anonymouschichvy/FishTrack-Buoy/open_echo/development/TUSS4470_PCB_ECHO/assembly.FCStd

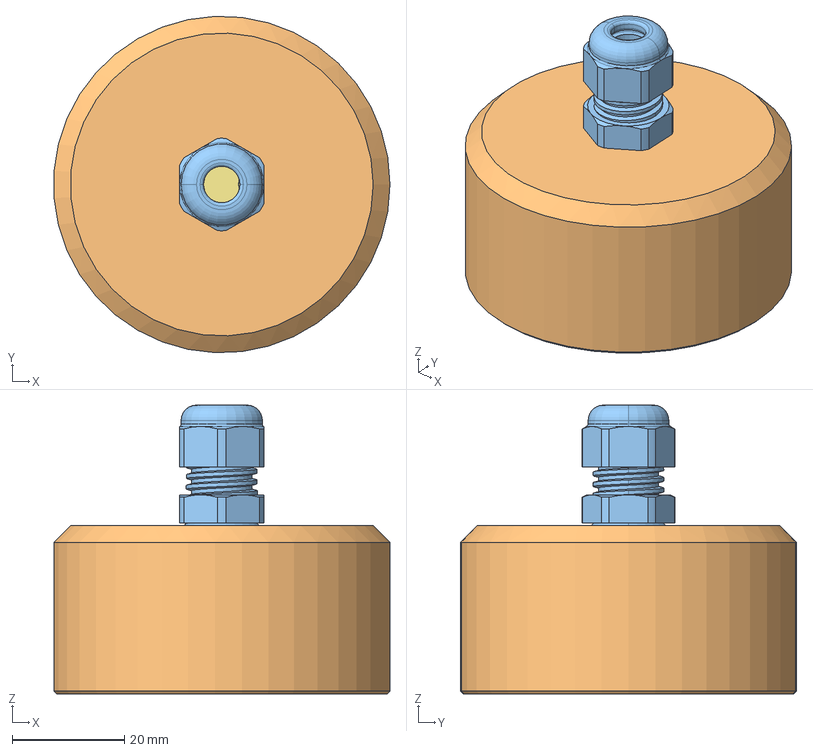
[picture p7: CAD file, 2026-06-20, last stored version]
open_echo/development/TUSS4470_PCB_ECHO/assembly.FCStd
59.9 x 60.0 x 51.5 mm
C_1206_3216Metric
R_1206_3216Metric
C_0402_1005Metric
R_0603_1608Metric
LED_0805_2012Metric
R_0603_1608Metric002
R_0402_1005Metric
C_0402_1005Metric002
QFN-20-1EP_4x4mm_Pitch0.5mm
D_SMA
R_0603_1608Metric004
C_0603_1608Metric
R_0603_1608Metric006
C_0402_1005Metric004
C_1206_3216Metric002
LED_0805_2012Metric002
LED_0805_2012Metric004
LQFP_48_7x7mm_P05mm
C_0603_1608Metric002
C_0603_1608Metric004
C_0402_1005Metric006
C_1206_3216Metric004
R_0603_1608Metric008
LED_0805_2012Metric006
C_1206_3216Metric006
C_0603_1608Metric006
SOT_223
R_1206_3216Metric002
LED_0805_2012Metric008
Crystal_SMD_5032-2Pin_5.0x3.2mm
C_0402_1005Metric008
C_0402_1005Metric010
C_0603_1608Metric008
R_0603_1608Metric010
R_0603_1608Metric012
R_0603_1608Metric014
C_1206_3216Metric008
C_0603_1608Metric010
QFN-28-1EP_5x5mm_Pitch0.5mm
_autosave-TUSS4470_shield_PCB
69915K47_Plastic Submersible Cord Grip
