anonymouschichvy/FishTrack-Buoy/open_echo/development/TUSS4470_PCB_ECHO/TUSS4470_shield/components/TUSS4470TRTJR.step

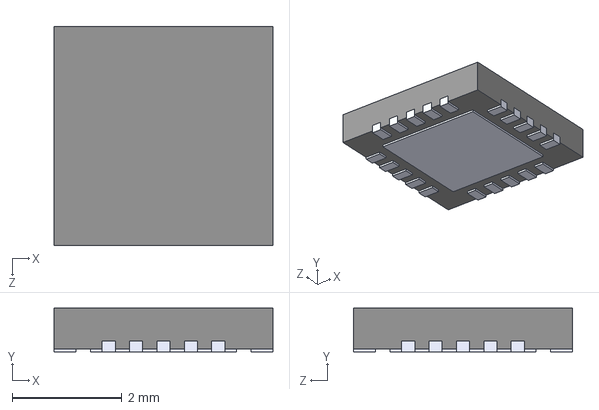
[picture p8: CAD file, 2026-06-20, last stored version]
open_echo/development/TUSS4470_PCB_ECHO/TUSS4470_shield/components/TUSS4470TRTJR.step
4.00 x 0.8 x 4.00 mm
