anonymouschichvy/FishTrack-Buoy/open_echo/TUSS4470_shield_002/TUSS4470_shield_hardware/TUSS4470_shield/TUSS4470_shield.step

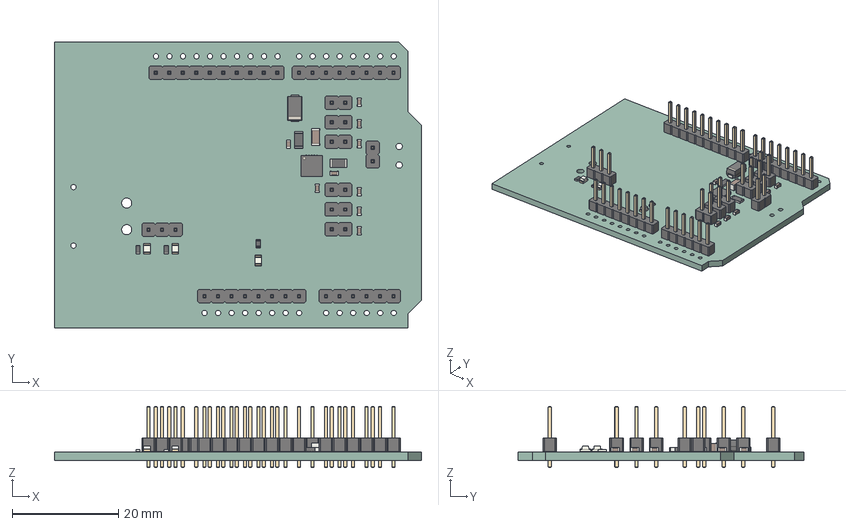
[picture p9: CAD file, 2026-06-20, last stored version]
open_echo/TUSS4470_shield_002/TUSS4470_shield_hardware/TUSS4470_shield/TUSS4470_shield.step
69.0 x 53.8 x 11.5 mm
R_1206_3216Metric x 2
LED_0805_2012Metric x 3
QFN-20-1EP_4x4mm_Pitch0.5mm
D_SMA
C_0603_1608Metric x 9
PinHeader_1x02_P254mm_Vertical x 7
PinHeader_1x06_P254mm_Vertical
R_0603_1608Metric x 3
C_1206_3216Metric
PinHeader_1x08_P254mm_Vertical x 2
PinHeader_1x10_P254mm_Vertical
PinHeader_1x03_P254mm_Vertical
TUSS4470_shield_PCB
