anonymouschichvy/FishTrack-Buoy/open_echo/development/TUSS4470_PCB_ECHO/TUSS4470_shield/components/piezo_3d.step

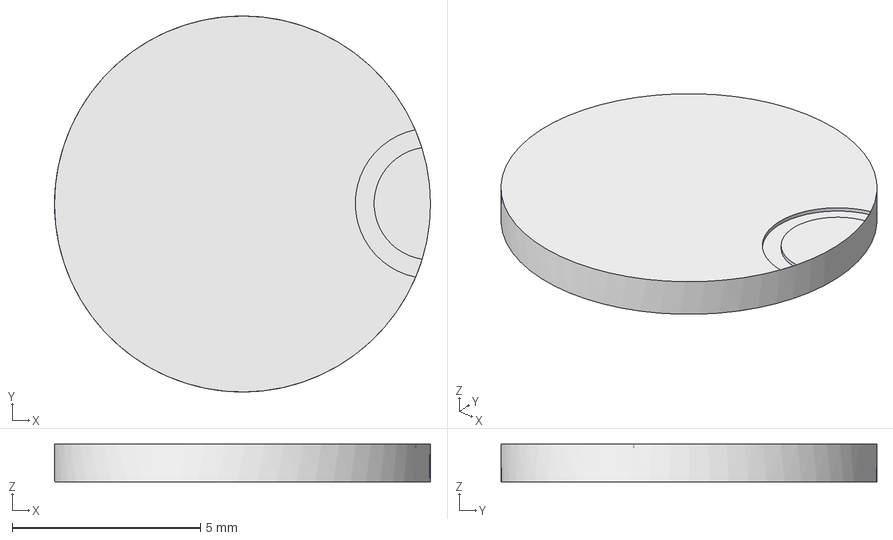
[picture p10: CAD file, 2026-06-20, last stored version]
open_echo/development/TUSS4470_PCB_ECHO/TUSS4470_shield/components/piezo_3d.step
10.00 x 10.00 x 1.00 mm
