anonymouschichvy/FishTrack-Buoy/open_echo/development/phased_array_001_pico/phased.kicad_pcb

## KiCad design open_echo/development/phased_array_001_pico/phased.kicad_pcb (2026-06-20, last stored version)

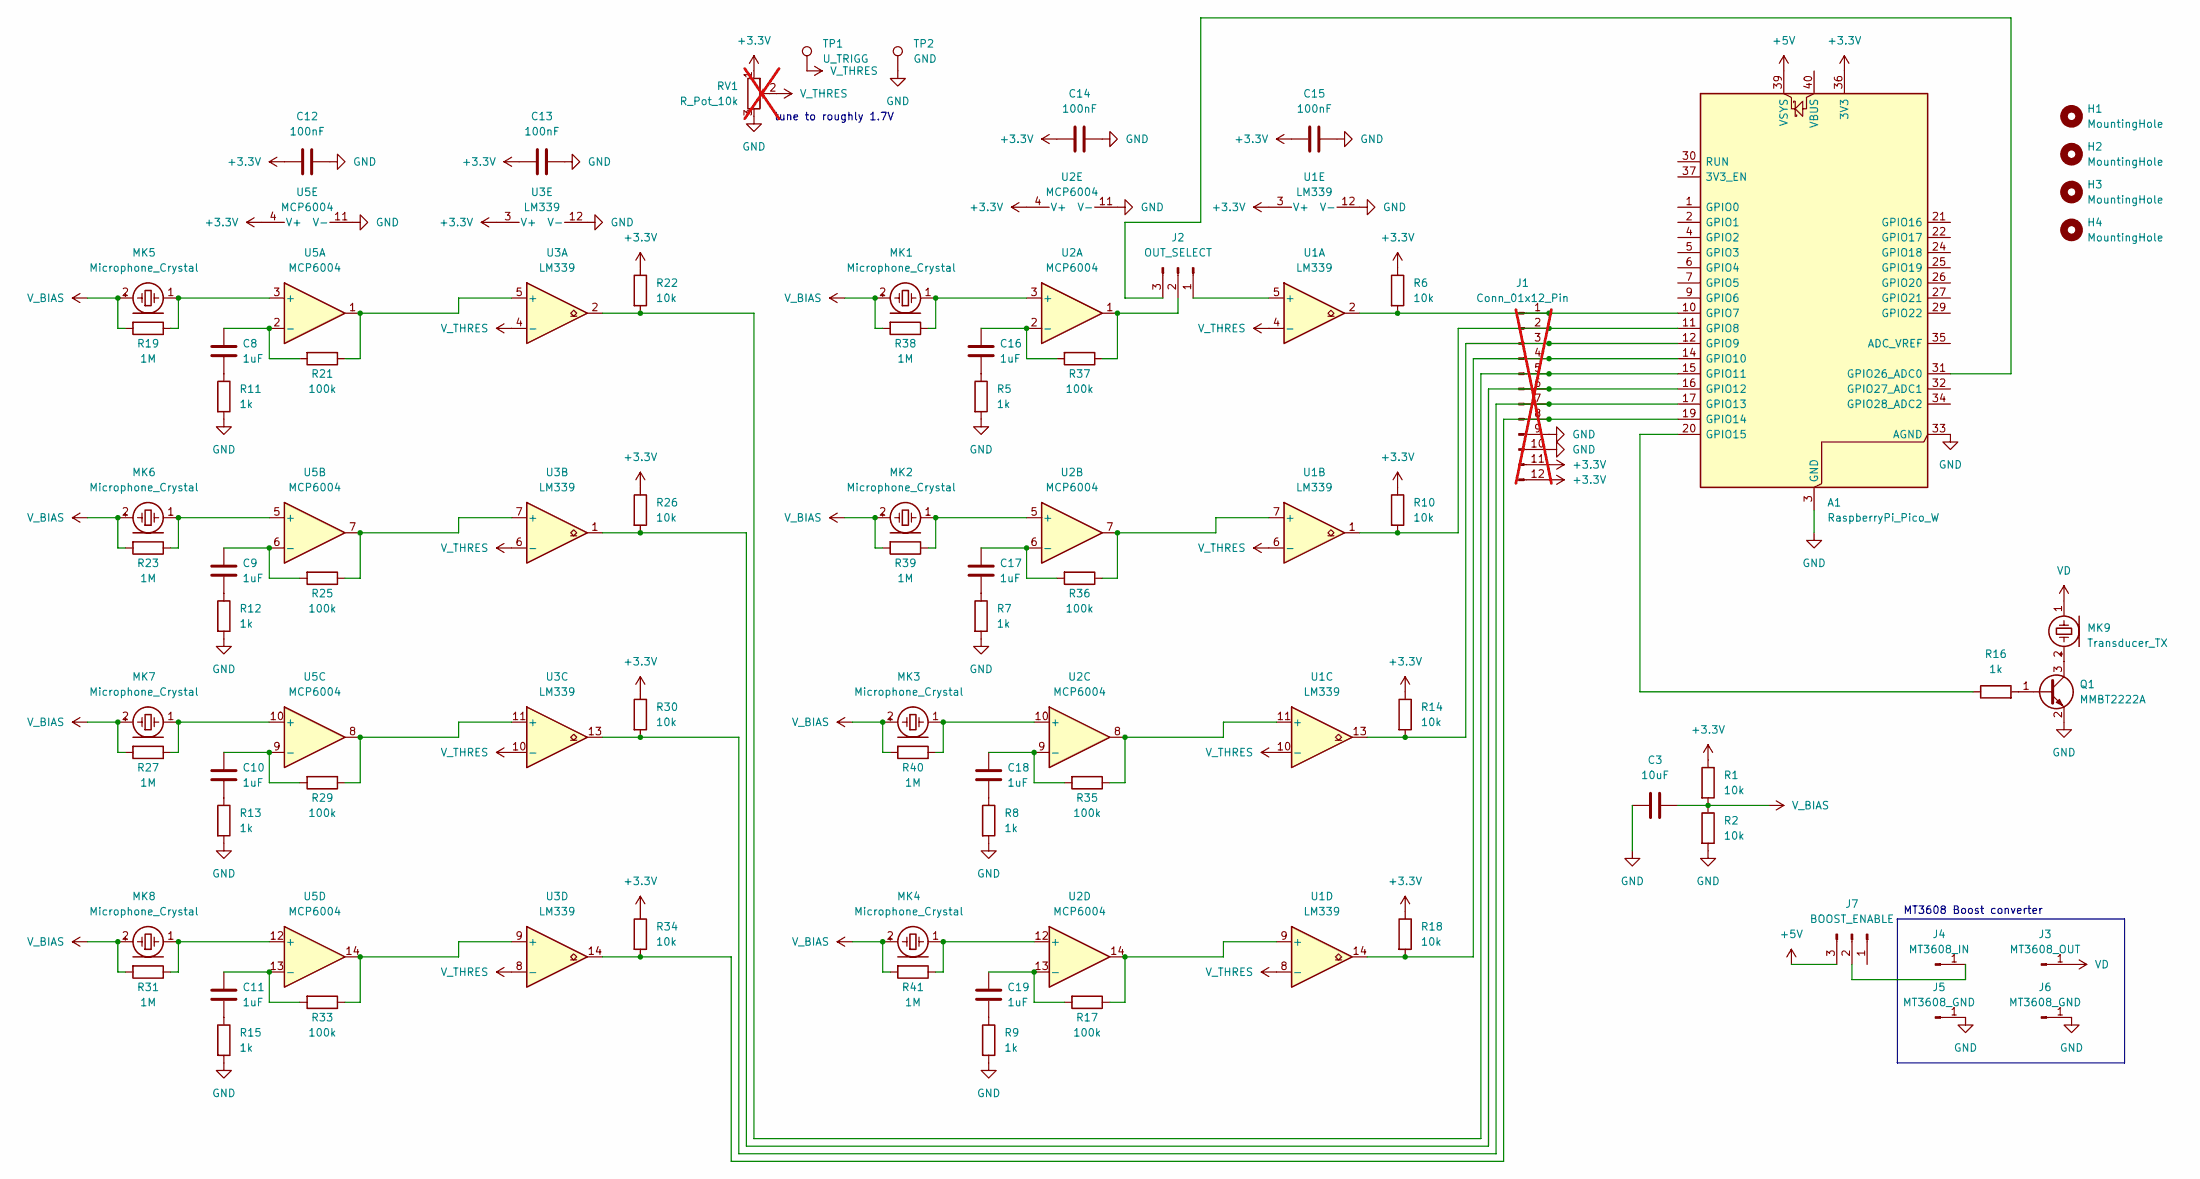
[picture p11: schematic phased.kicad_sch]

Parts:
A1: RaspberryPi_Pico_W; RaspberryPi_Pico_Common_Unspecified
C3: 10uF; C_0603_1608Metric; LCSC C19702
C8, C9, C10, C11, C16, C17, C18, C19: 1uF; C_0603_1608Metric; LCSC C15849
C12, C13, C14, C15: 100nF; C_0603_1608Metric; LCSC C1525
H1, H2, H3, H4: MountingHole; MountingHole_3.2mm_M3
J1: Conn_01x12_Pin; PinHeader_1x12_P2.54mm_Vertical; not fitted
J2: OUT_SELECT; PinHeader_1x03_P2.54mm_Vertical
J3: MT3608_OUT; PinHeader_1x01_P2.54mm_Vertical
J4: MT3608_IN; PinHeader_1x01_P2.54mm_Vertical
J5, J6: MT3608_GND; PinHeader_1x01_P2.54mm_Vertical
J7: BOOST_ENABLE; PinHeader_1x03_P2.54mm_Vertical
MK1, MK2, MK3, MK4, MK5, MK6, MK7, MK8: Microphone_Crystal; JST_EH_S2B-EH_1x02_P2.50mm_Horizontal
MK9: Transducer_TX; JST_EH_S2B-EH_1x02_P2.50mm_Horizontal
Q1: MMBT2222A; SOT-23; LCSC C8512
R1, R2, R6, R10, R14, R18, R22, R26, R30, R34: 10k; R_0603_1608Metric; LCSC C25804
R5, R7, R8, R9, R11, R12, R13, R15, R16: 1k; R_0603_1608Metric; LCSC C21190
R17, R21, R25, R29, R33, R35, R36, R37: 100k; R_0603_1608Metric; LCSC C25803
R19, R23, R27, R31, R38, R39, R40, R41: 1M; R_0603_1608Metric; LCSC C22935
RV1: R_Pot_10k; Potentiometer_Bourns_3296W_Vertical; not fitted
TP1: U_TRIGG; TestPoint_Loop_D2.54mm_Drill1.5mm_Beaded
TP2: GND; TestPoint_Loop_D2.54mm_Drill1.5mm_Beaded
U1, U3: LM339; SOIC-14_3.9x8.7mm_P1.27mm; LCSC C7948
U2, U5: MCP6004; SOIC-14_3.9x8.7mm_P1.27mm; LCSC C7378

Connections:
+3.3V: A1.36 (3V3), C12.1, C13.1, C14.1, C15.1, J1.11, J1.12, R1.1, R6.1, R10.1, R14.1, R18.1, R22.1, R26.1, R30.1, R34.1, RV1.1, U1.3 (V+), U2.4 (V+), U3.3 (V+), U5.4 (V+)
+5V: A1.39 (VSYS), J7.3
GND: A1.3 (GND), A1.8 (GND), A1.13 (GND), A1.18 (GND), A1.23 (GND), A1.28 (GND), A1.33 (AGND), A1.38 (GND), C3.2, C12.2, C13.2, C14.2, C15.2, J1.9, J1.10, J5.1 (Pin_1_1), J6.1 (Pin_1_1), Q1.2 (E), R2.2, R5.2, R7.2, R8.2, R9.2, R11.2, R12.2, R13.2, R15.2, RV1.3, TP2.1 (1_1), U1.12 (V-), U2.11 (V-), U3.12 (V-), U5.11 (V-)
unnamed: A1.10 (GPIO7), J1.1, R6.2, U1.2
unnamed: A1.11 (GPIO8), J1.2, R10.2, U1.1
unnamed: A1.12 (GPIO9), J1.3, R14.2, U1.13
unnamed: A1.14 (GPIO10), J1.4, R18.2, U1.14
unnamed: A1.15 (GPIO11), J1.5, R22.2, U3.2
unnamed: A1.16 (GPIO12), J1.6, R26.2, U3.1
unnamed: A1.17 (GPIO13), J1.7, R30.2, U3.13
unnamed: A1.19 (GPIO14), J1.8, R34.2, U3.14
unnamed: A1.20 (GPIO15), R16.1
unnamed: A1.31 (GPIO26_ADC0), J2.3
unnamed: C8.1, R11.1
unnamed: C9.1, R12.1
unnamed: C10.1, R13.1
unnamed: C11.1, R15.1
unnamed: C16.1, R5.1
unnamed: C17.1, R7.1
unnamed: C18.1, R8.1
unnamed: C19.1, R9.1
unnamed: J2.1, U1.5 (+)
unnamed: J2.2, R37.1, U2.1
unnamed: J4.1 (Pin_1_1), J7.2
unnamed: MK1.1 (-), R38.1, U2.3 (+)
unnamed: MK2.1 (-), R39.1, U2.5 (+)
unnamed: MK3.1 (-), R40.1, U2.10 (+)
unnamed: MK4.1 (-), R41.1, U2.12 (+)
unnamed: MK5.1 (-), R19.1, U5.3 (+)
unnamed: MK6.1 (-), R23.1, U5.5 (+)
unnamed: MK7.1 (-), R27.1, U5.10 (+)
unnamed: MK8.1 (-), R31.1, U5.12 (+)
unnamed: MK9.2 (+), Q1.3 (C)
unnamed: Q1.1 (B), R16.2
unnamed: R36.1, U1.7 (+), U2.7
unnamed: R35.1, U1.11 (+), U2.8
unnamed: R17.1, U1.9 (+), U2.14
unnamed: C16.2, R37.2, U2.2 (-)
unnamed: C17.2, R36.2, U2.6 (-)
unnamed: C18.2, R35.2, U2.9 (-)
unnamed: C19.2, R17.2, U2.13 (-)
unnamed: R21.1, U3.5 (+), U5.1
unnamed: R25.1, U3.7 (+), U5.7
unnamed: R29.1, U3.11 (+), U5.8
unnamed: R33.1, U3.9 (+), U5.14
unnamed: C8.2, R21.2, U5.2 (-)
unnamed: C9.2, R25.2, U5.6 (-)
unnamed: C10.2, R29.2, U5.9 (-)
unnamed: C11.2, R33.2, U5.13 (-)
VD: J3.1 (Pin_1_1), MK9.1 (-)
V_BIAS: C3.1, MK1.2 (+), MK2.2 (+), MK3.2 (+), MK4.2 (+), MK5.2 (+), MK6.2 (+), MK7.2 (+), MK8.2 (+), R1.2, R2.1, R19.2, R23.2, R27.2, R31.2, R38.2, R39.2, R40.2, R41.2
V_THRES: RV1.2, TP1.1 (1_1), U1.4 (-), U1.6 (-), U1.8 (-), U1.10 (-), U3.4 (-), U3.6 (-), U3.8 (-), U3.10 (-)

Notes on the sheet:
tune to roughly 1.7V
MT3608 Boost converter

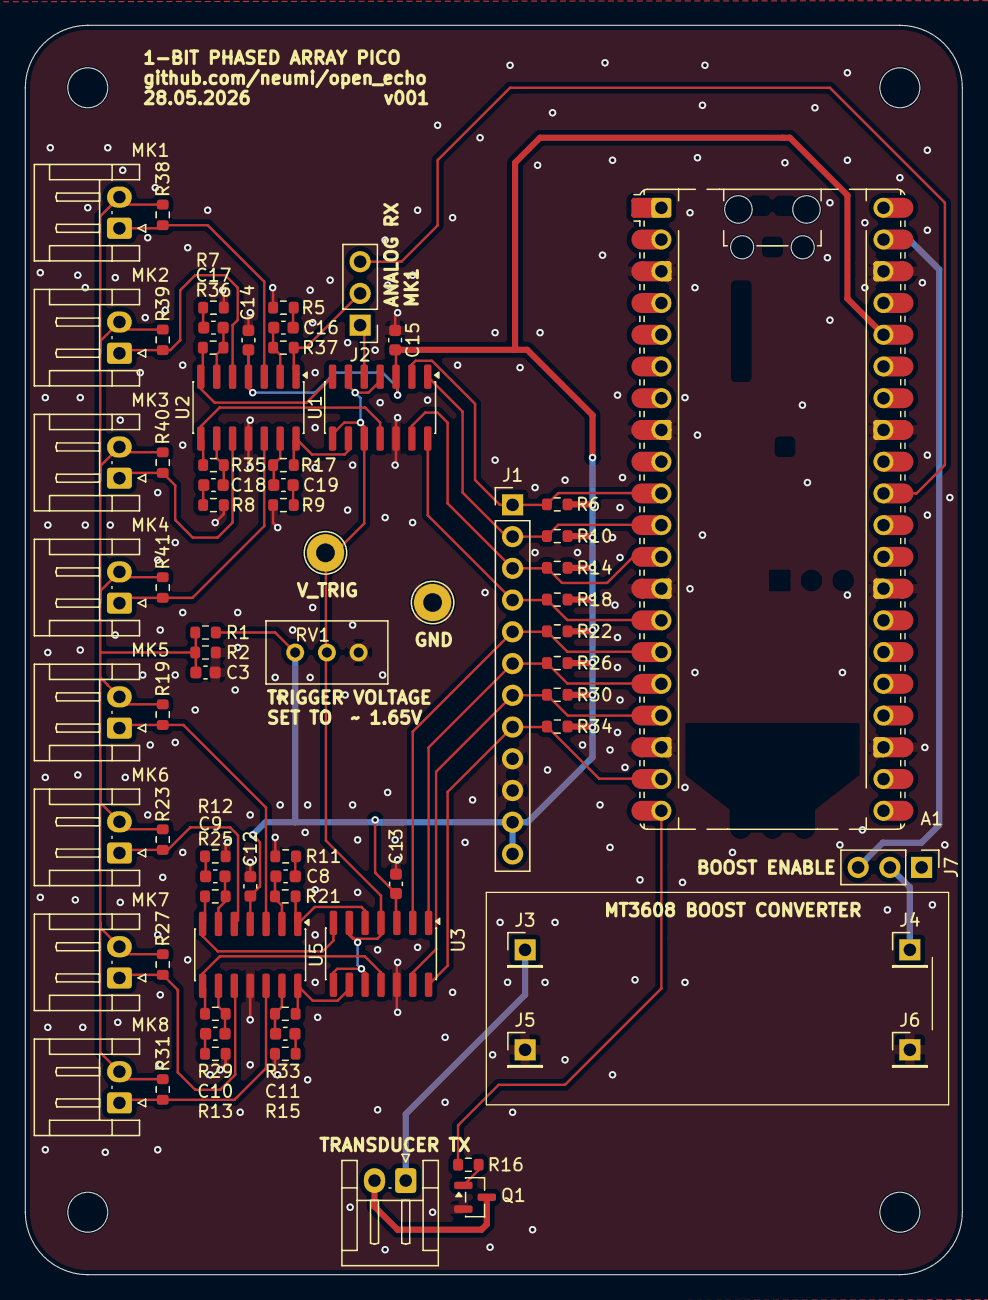
[picture p12: board phased.kicad_pcb from above]

Board: 2 copper layers, 75.0 x 100.0 mm, 77 parts (0 on the bottom side), 52 nets.
