anonymouschichvy/FishTrack-Buoy/open_echo/TUSS4470_shield_002/TUSS4470_shield_hardware/TUSS4470_shield/TUSS4470_shield.kicad_pcb

## KiCad design open_echo/TUSS4470_shield_002/TUSS4470_shield_hardware/TUSS4470_shield/TUSS4470_shield.kicad_pcb (2026-06-20, last stored version)

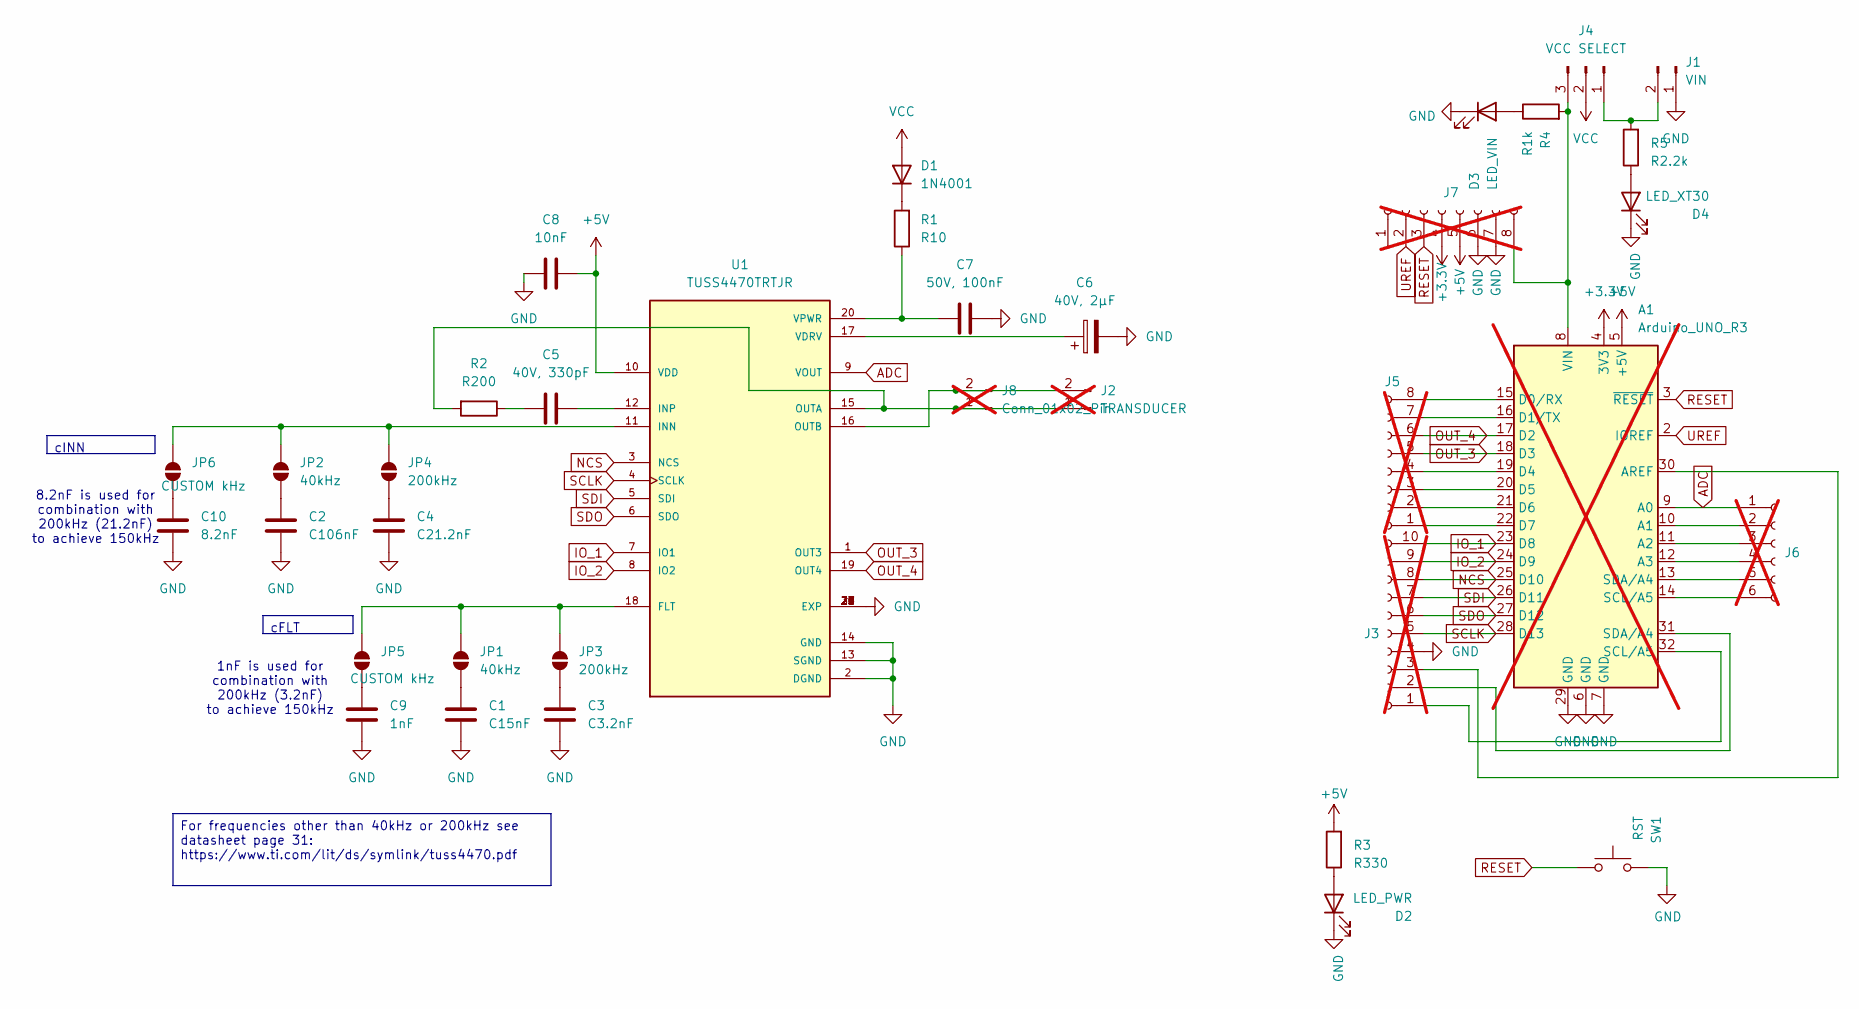
[picture p13: schematic TUSS4470_shield.kicad_sch]

Parts:
A1: Arduino_UNO_R3; not fitted
C1: C15nF; C_0603_1608Metric; LCSC C1596
C2: C106nF; C_0603_1608Metric; LCSC C14663
C3: C3.2nF; C_0603_1608Metric; LCSC C1613
C4: C21.2nF; C_0603_1608Metric; LCSC C1602
C5: 40V, 330pF; C_0603_1608Metric; LCSC C1664
C6: 40V, 2µF; C_1206_3216Metric; LCSC C50254
C7: 50V, 100nF; C_0603_1608Metric; LCSC C14663
C8: 10nF; C_0603_1608Metric; LCSC C57112
C9: 1nF; C_0603_1608Metric; LCSC C1588
C10: 8.2nF; C_0603_1608Metric; LCSC C1322360
D1: 1N4001; D_SMA; LCSC C727079
D2: LED_PWR; LED_0805_2012Metric; LCSC C84256
D3: LED_VIN; LED_0805_2012Metric; LCSC C84256
D4: LED_XT30; LED_0805_2012Metric; LCSC C84256
J1: VIN; AMASS_XT30PW-M_1x02_P2.50mm_Horizontal; LCSC C431092
J2: TRANSDUCER; TerminalBlock_4Ucon_1x02_P3.50mm_Horizontal; not fitted
J3: Conn_01x10_Socket; PinHeader_1x10_P2.54mm_Vertical; not fitted
J4: VCC SELECT; PinHeader_1x03_P2.54mm_Vertical; LCSC C49257
J5, J7: Conn_01x08_Socket; PinHeader_1x08_P2.54mm_Vertical; not fitted
J6: Conn_01x06_Socket; PinHeader_1x06_P2.54mm_Vertical; not fitted
J8: Conn_01x02_Pin; PinHeader_1x02_P2.54mm_Vertical; not fitted
JP1, JP2: 40kHz; PinHeader_1x02_P2.54mm_Vertical; LCSC C2905434
JP3, JP4: 200kHz; PinHeader_1x02_P2.54mm_Vertical; LCSC C2905434
JP5, JP6: CUSTOM kHz; PinHeader_1x02_P2.54mm_Vertical; LCSC C2905434
R1: R10; R_1206_3216Metric; LCSC C17903
R2: R200; R_1206_3216Metric; LCSC C18002
R3: R330; R_0603_1608Metric; LCSC C23138
R4: R1k; R_0603_1608Metric; LCSC C14676
R5: R2.2k; R_0603_1608Metric; LCSC C4190
SW1: RST; SW_Push_1P1T_NO_CK_KSC7xxJ; LCSC C318884
U1: TUSS4470TRTJR; QFN-20-1EP_4x4mm_P0.5mm_EP2.5x2.5mm_ThermalVias; PARTREV December 2019; LCSC C1855776

Connections:
+3.3V: A1.4 (3V3), J7.4
+5V: A1.5 (+5V), C8.2, J7.5, R3.2, U1.10 (VDD)
ADC: A1.9 (A0), J6.1, U1.9 (VOUT)
GND: A1.6 (GND), A1.7 (GND), A1.29 (GND), C1.2, C2.2, C3.2, C4.2, C6.2, C7.2, C8.1, C9.2, C10.2, D2.1 (K), D3.1 (K), D4.1 (K), J1.1, J3.4, J7.6, J7.7, SW1.2, U1.2 (DGND), U1.13 (SGND), U1.14 (GND), U1.21 (EXP), U1.22 (EXP), U1.23 (EXP), U1.24 (EXP), U1.25 (EXP), U1.26 (EXP), U1.27 (EXP), U1.28 (EXP), U1.29 (EXP), U1.30 (EXP)
IO_1: A1.23 (D8), J3.10, U1.7 (IO1)
IO_2: A1.24 (D9), J3.9, U1.8 (IO2)
NCS: A1.25 (D10), J3.8, U1.3 (NCS)
unnamed: A1.10 (A1), J6.2
unnamed: A1.11 (A2), J6.3
unnamed: A1.12 (A3), J6.4
unnamed: A1.30 (AREF), J3.3
unnamed: A1.15 (D0/RX), J5.8
unnamed: A1.16 (D1/TX), J5.7
unnamed: A1.19 (D4), J5.4
unnamed: A1.20 (D5), J5.3
unnamed: A1.21 (D6), J5.2
unnamed: A1.22 (D7), J5.1
unnamed: A1.8 (VIN), J4.3, J7.8, R4.2
unnamed: C5.1, R2.1
unnamed: D1.1 (K), R1.2
unnamed: D2.2 (A), R3.1
unnamed: D3.2 (A), R4.1
unnamed: D4.2 (A), R5.1
unnamed: J1.2, J4.1, R5.2
unnamed: J2.1, J8.1, R2.2, U1.15 (OUTA)
unnamed: J2.2, J8.2, U1.16 (OUTB)
unnamed: A1.32 (SCL/A5), J3.1
unnamed: A1.31 (SDA/A4), J3.2
unnamed: A1.13 (SDA/A4), J6.5
unnamed: A1.14 (SCL/A5), J6.6
unnamed: C1.1, JP1.1 (A)
unnamed: JP1.2 (B), JP3.2 (B), JP5.2 (B), U1.18 (FLT)
unnamed: C2.1, JP2.1 (A)
unnamed: JP2.2 (B), JP4.2 (B), JP6.2 (B), U1.11 (INN)
unnamed: C3.1, JP3.1 (A)
unnamed: C4.1, JP4.1 (A)
unnamed: C9.1, JP5.1 (A)
unnamed: C10.1, JP6.1 (A)
unnamed: C5.2, U1.12 (INP)
unnamed: C6.1, U1.17 (VDRV)
unnamed: C7.1, R1.1, U1.20 (VPWR)
OUT_3: A1.18 (D3), J5.5, U1.1 (OUT3)
OUT_4: A1.17 (D2), J5.6, U1.19 (OUT4)
RESET: A1.3 (~RESET), J7.3, SW1.1
SCLK: A1.28 (D13), J3.5, U1.4 (SCLK)
SDI: A1.26 (D11), J3.7, U1.5 (SDI)
SDO: A1.27 (D12), J3.6, U1.6 (SDO)
UREF: A1.2 (IOREF), J7.2
VCC: D1.2 (A), J4.2

Notes on the sheet:
8.2nF is used for combination with 200kHz (21.2nF) to achieve 150kHz
1nF is used for combination with 200kHz (3.2nF) to achieve 150kHz
cFLT
For frequencies other than 40kHz or 200kHz see datasheet page 31: https://www.ti.com/lit/ds/symlink/tuss4470.pdf
cINN

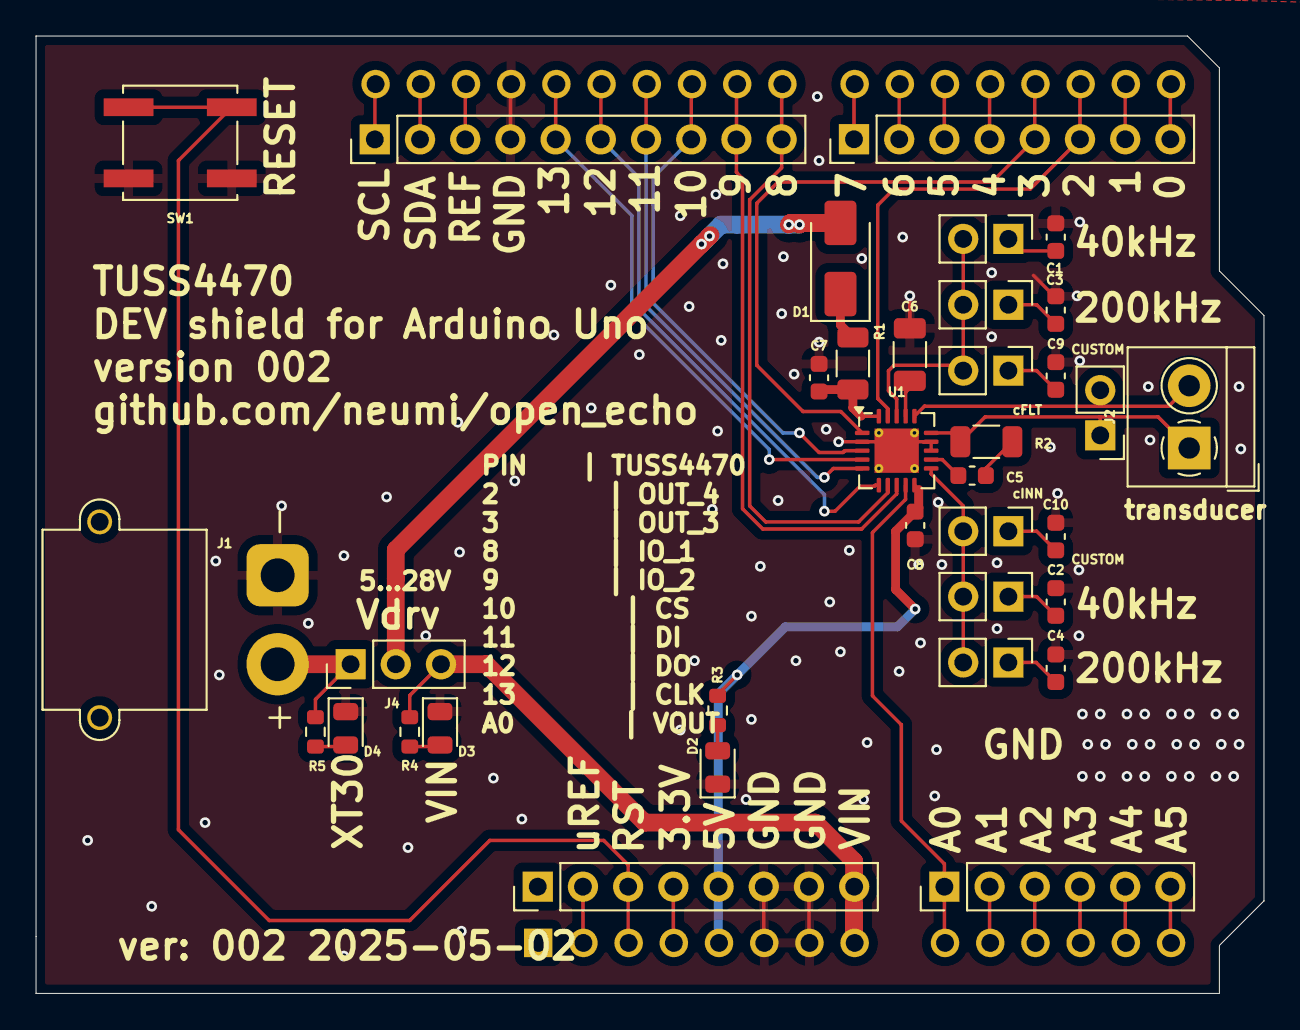
[picture p14: board open_echo/TUSS4470_shield_002/TUSS4470_shield_hardware/TUSS4470_shiel… from above]

Board: 2 copper layers, 69.0 x 53.8 mm, 36 parts (1 on the bottom side), 49 nets.
