anonymouschichvy/FishTrack-Buoy/open_echo/development/TUSS4470_shield_02/TUSS4470_shield/TUSS4470_shield.kicad_pcb

## KiCad design open_echo/development/TUSS4470_shield_02/TUSS4470_shield/TUSS4470_shield.kicad_pcb (2026-06-20, last stored version)

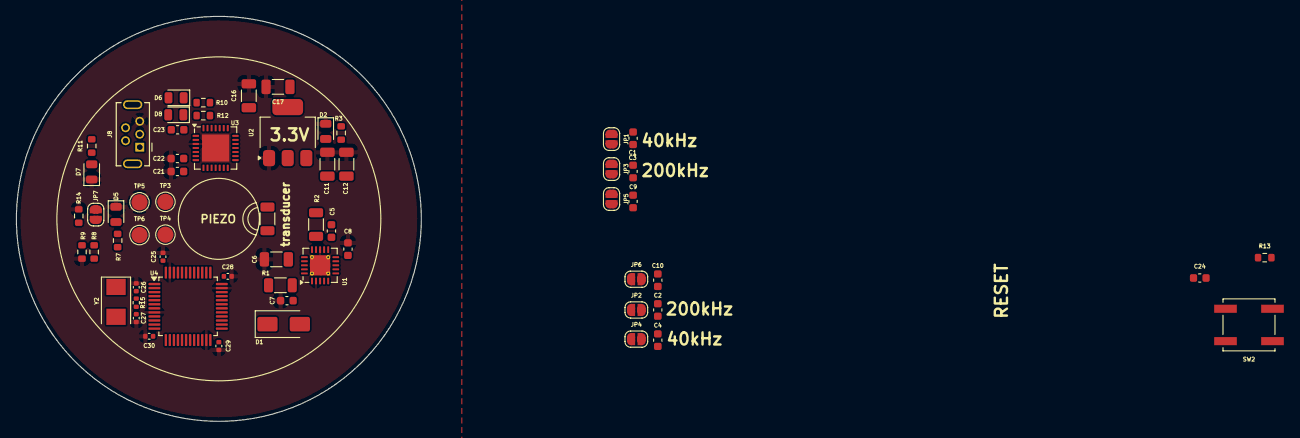
[picture p15: board open_echo/development/TUSS4470_shield_02/TUSS4470_shield/TUSS4470_shi… from above]

Board: 2 copper layers, 50.0 x 50.0 mm, 61 parts (0 on the bottom side), 36 nets, no tracks yet.

Parts:
C1: C15nF; C_0603_1608Metric
C2: C106nF; C_0603_1608Metric
C3: C3.2nF; C_0603_1608Metric
C4: C21.2nF; C_0603_1608Metric
C5: 40V, 330pF; C_0603_1608Metric
C6: 40V, 2µF; C_1206_3216Metric
C7: 50V, 100nF; C_0603_1608Metric
C8: 10nF; C_0603_1608Metric
C9, C10: CXXnF; C_0603_1608Metric
C11, C16: C100nF; C_1206_3216Metric
C12, C17: C47uF; C_1206_3216Metric
C21, C22, C23, C24: C100nF; C_0603_1608Metric
C25, C28, C29, C30: C100nF; C_0402_1005Metric
C26, C27: C22pF; C_0402_1005Metric
D1: 1N4001; D_SMA
D2: LED_PWR; LED_0805_2012Metric
D5: LED_PC13; LED_0805_2012Metric
D6: TX; LED_0805_2012Metric
D7: LED_3.3V_PWR; LED_0805_2012Metric
D8: RX; LED_0805_2012Metric
J8: USB_B_Mini; USB_Mini-B_Tensility_54-00023_Vertical
JP1, JP2: 40kHz; SolderJumper-2_P1.3mm_Open_RoundedPad1.0x1.5mm
JP3, JP4: 200kHz; SolderJumper-2_P1.3mm_Open_RoundedPad1.0x1.5mm
JP5, JP6: CUSTOM kHz; SolderJumper-2_P1.3mm_Open_RoundedPad1.0x1.5mm
JP7: termination_jumper; SolderJumper-2_P1.3mm_Open_RoundedPad1.0x1.5mm
R1: R10; R_1206_3216Metric
R2: R200; R_1206_3216Metric
R3, R10, R11, R12: R330; R_0603_1608Metric
R7, R8, R9: R1k; R_0603_1608Metric
R13, R14: R10k; R_0603_1608Metric
R15: R1M; R_0402_1005Metric
SW2: RST; SW_Push_1P1T_NO_CK_KSC7xxJ
TP3: RX; TestPoint_Pad_D2.0mm
TP4: TX; TestPoint_Pad_D2.0mm
TP5: GND; TestPoint_Pad_D2.0mm
TP6: 3.3V; TestPoint_Pad_D2.0mm
U1: TUSS4470TRTJR; QFN-20-1EP_4x4mm_P0.5mm_EP2.5x2.5mm_ThermalVias
U2: AMS1117-3.3; SOT-223-3_TabPin2
U3: CP2102N-A01-GQFN28; QFN-28-1EP_5x5mm_P0.5mm_EP3.35x3.35mm
U4: STM32F103C8Tx; LQFP-48_7x7mm_P0.5mm
Y1: Crystal; R_1206_3216Metric
Y2: Crystal; Crystal_SMD_5032-2Pin_5.0x3.2mm

Connections:
5V_voltage_detect: R8.2, R9.1, U4.19 (PB1)
+3.3V: C16.1, C17.1, C25.1, C28.1, C29.1, C30.1, D6.2 (A), D8.2 (A), JP7.2 (B), R11.2, R13.1, TP6.1, U2.2 (VO), U4.9 (VDDA), U4.24 (VDD), U4.36 (VDD), U4.48 (VDD)
+5V: C8.2, C11.1, C12.1, R3.2, R8.1, U1.10 (VDD), U2.3 (VI)
BOOT_0: JP7.1 (A), R14.1, U4.44 (BOOT0)
GND: C1.2, C2.2, C3.2, C4.2, C6.2, C7.2, C8.1, C9.2, C10.2, C11.2, C12.2, C16.2, C17.2, C21.1, C22.1, C24.2, C25.2, C26.1, C27.2, C28.2, C29.2, C30.2, D2.1 (K), D5.1 (K), D7.1 (K), J8.5 (GND), R9.2, R14.2, SW2.2, TP5.1, U1.2 (DGND), U1.13 (SGND), U1.14 (GND), U1.21 (EXP), U2.1 (GND), U3.3 (GND), U3.29 (GND), U4.8 (VSSA), U4.23 (VSS), U4.35 (VSS), U4.47 (VSS)
unnamed: C5.1, R2.1
unnamed: D1.1 (K), R1.2
unnamed: D2.2 (A), R3.1
unnamed: D5.2 (A), R7.1
unnamed: D6.1 (K), R10.1
unnamed: D7.2 (A), R11.1
unnamed: D8.1 (K), R12.1
unnamed: J8.3 (D+), U3.4 (D+)
unnamed: J8.2 (D-), U3.5 (D-)
unnamed: C21.2, J8.1 (VBUS), U3.7 (REGIN), U3.8 (VBUS)
unnamed: C1.1, JP1.1 (A)
unnamed: JP1.2 (B), JP3.2 (B), JP5.2 (B), U1.18 (FLT)
unnamed: C2.1, JP2.1 (A)
unnamed: JP2.2 (B), JP4.2 (B), JP6.2 (B), U1.11 (INN)
unnamed: C3.1, JP3.1 (A)
unnamed: C4.1, JP4.1 (A)
unnamed: C9.1, JP5.1 (A)
unnamed: C10.1, JP6.1 (A)
unnamed: C5.2, U1.12 (INP)
unnamed: R2.2, U1.15 (OUTA), Y1.2
unnamed: U1.16 (OUTB), Y1.1
unnamed: C6.1, U1.17 (VDRV)
unnamed: C7.1, R1.1, U1.20 (VPWR)
unnamed: C22.2, U3.6 (VDD)
unnamed: C23.1, U3.28 (~DTR)
unnamed: R7.2, U4.2 (PC13-TAMPER-RTC)
unnamed: C26.2, R15.1, U4.5 (PD0-OSC_IN), Y2.1
unnamed: C27.1, R15.2, U4.6 (PD0-OSC_OUT), Y2.2
rst: C23.2, C24.1, R13.2, SW2.1, U4.7 (NRST)
uC_RX: R12.2, TP3.1, U3.26 (TXD), U4.31 (PA10)
uC_TX: R10.2, TP4.1, U3.25 (RXD), U4.30 (PA9)
