anonymouschichvy/FishTrack-Buoy/(commit log)

2026-06-20 Initial commit: Modular buoy network controller, configs, hardware interfaces, mesh networking, and integrated external source repositories (open_echo and fish-identification).
    [TUSS4470TRTJR.step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]
2026-06-20 Update README.md with creative product design gallery and full comparative Bill of Materials (BoM)
2026-06-20 Update camera reference in AI Target Identification section
2026-06-20 Enhance README with technology badges
    Added badges for Python, Raspberry Pi, Arduino, YOLOv10, LoRa, OpenCV, GPS, and Solar MPPT to the README.
2026-06-24 Add README files for multiple subsystems
    Add README.md documents for COOLING_RELAY, FISHCOMPILE, FISHDETECTION, FISHSPECIES, GPS_MODULE, LED_WAYFINDER, LORA USB BUS, SONAR_DATA, and UPS_HAT_E. Each README provides an overview, architecture/logic flow, formulas or algorithms, source code map and run/setup instructions to improve developer onboarding and system maintenance.
